serbanandi/robonaut2026/telemetry/README.md

Review Assignment Due Date (https://classroom.github.com/a/3GR8gYHV)
# Házi feladat

Név/Nevek NEPTUN kóddal:
- Minta Név (ABC123)

# Feladat kiírás
A minta feladat egy klasszikus *Aknakereső (Minesweeper)* játék elkészítése grafikus felülettel. A játék célja a mezőn lévő összes akna megtalálása, illetve az összes aknát nem rejtő mező felfedése. A játék indulásakor a pálya egyszínű négyzetekből áll, amelyek alatt aknák rejtőzködhetnek. A tábla mérete és az aknák száma nehézségi szintek alapján változik. A mezők állapota lehet lefedett, felfedett (szomszédos aknák számát mutatja), felfedett aknával, zászlós, kérdőjeles. Az egyes állapotok között az egér gombjaival válthatunk. stb, stb.
A program az alábbi funkciókkal fog rendelkezni:
* Grafikus felület Qt-ban megvalósítva.
* Nehézségi szintek választása különböző tábla méretekkel és akna számokkal.
* Az aknák véletlenszerű elhelyezése.
* A játék menetének implementálása a felsorolt mezőállapotokkal, a köztük való váltással és a vége állapotok ellenőrzésével.
* A játék idejének mérése.

# Megvalósított program
Milyen funkciókat sikerült megvalósítani? Milyen eltérések vannak a kiíráshoz képest? Hogyan kell bekonfigurálni, elindítani?

**Bemutató videó URL:**
(Szerepeljen benne minden lényeges funkció és az esetleges eltérések a kiíráshoz képest. max. 5 perc)

# Tapasztalatok
Milyen tapasztalatokat gyűjtött a feladat elkészítése során? Mi volt egyszerűbb / nehezebb a tervezetnél? Visszatekintve mit csinálna másként? (pár mondatban)
