serbanandi/robonaut2026/hardware/shield/shield.kicad_pcb

## KiCad design hardware/shield/shield.kicad_pcb (2025-11-16)

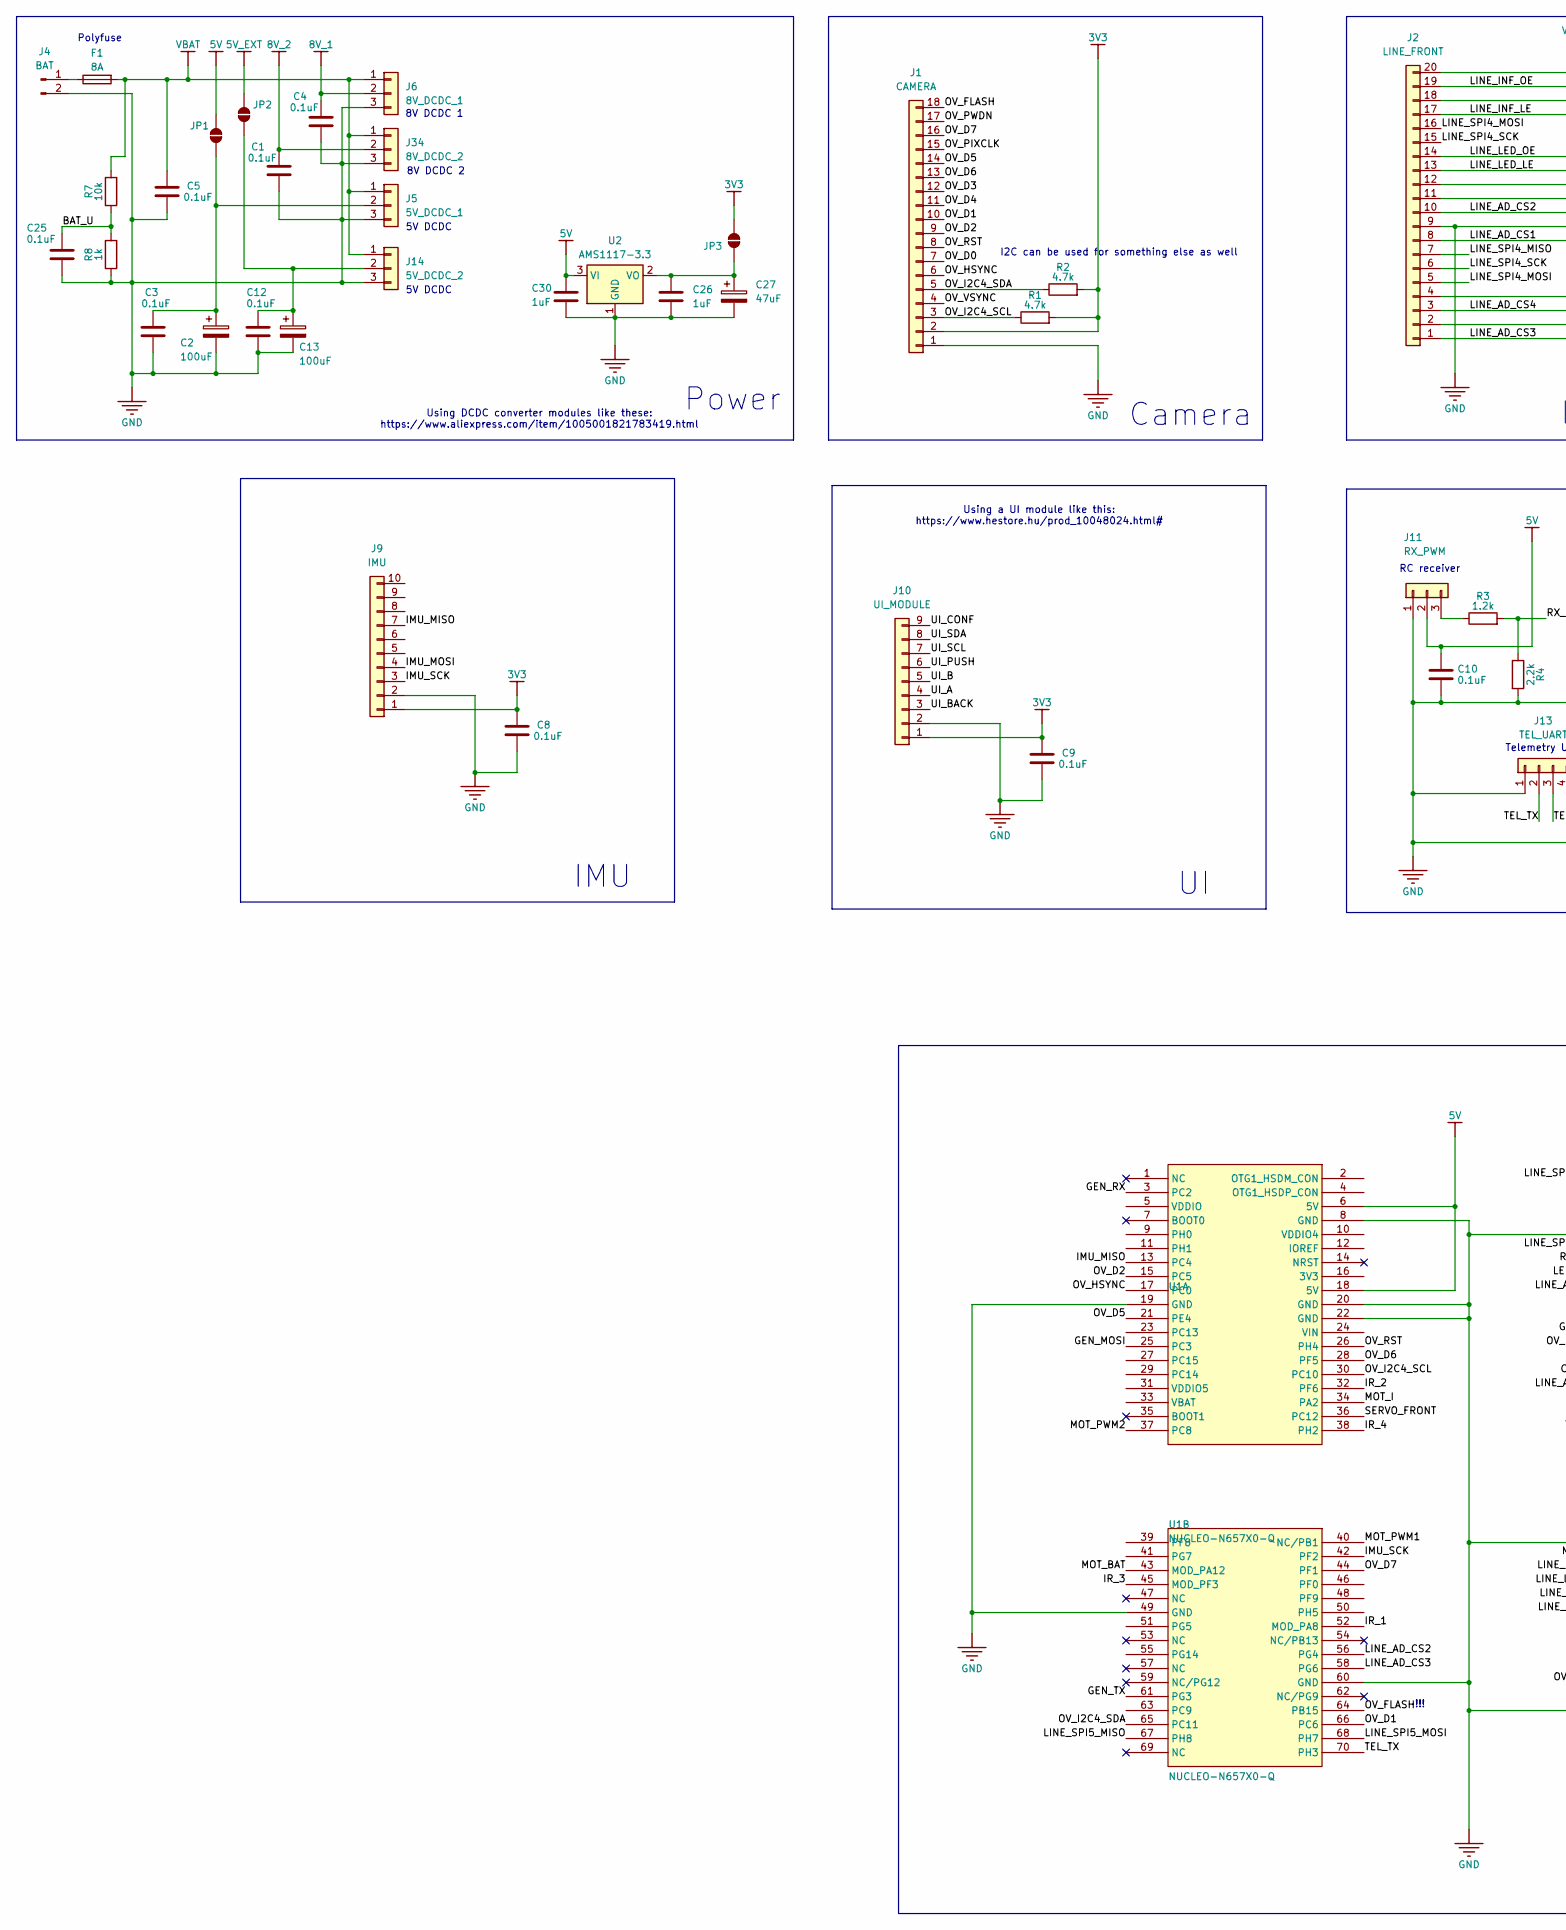
[picture p1: schematic shield.kicad_sch, part in row 1, column 1]

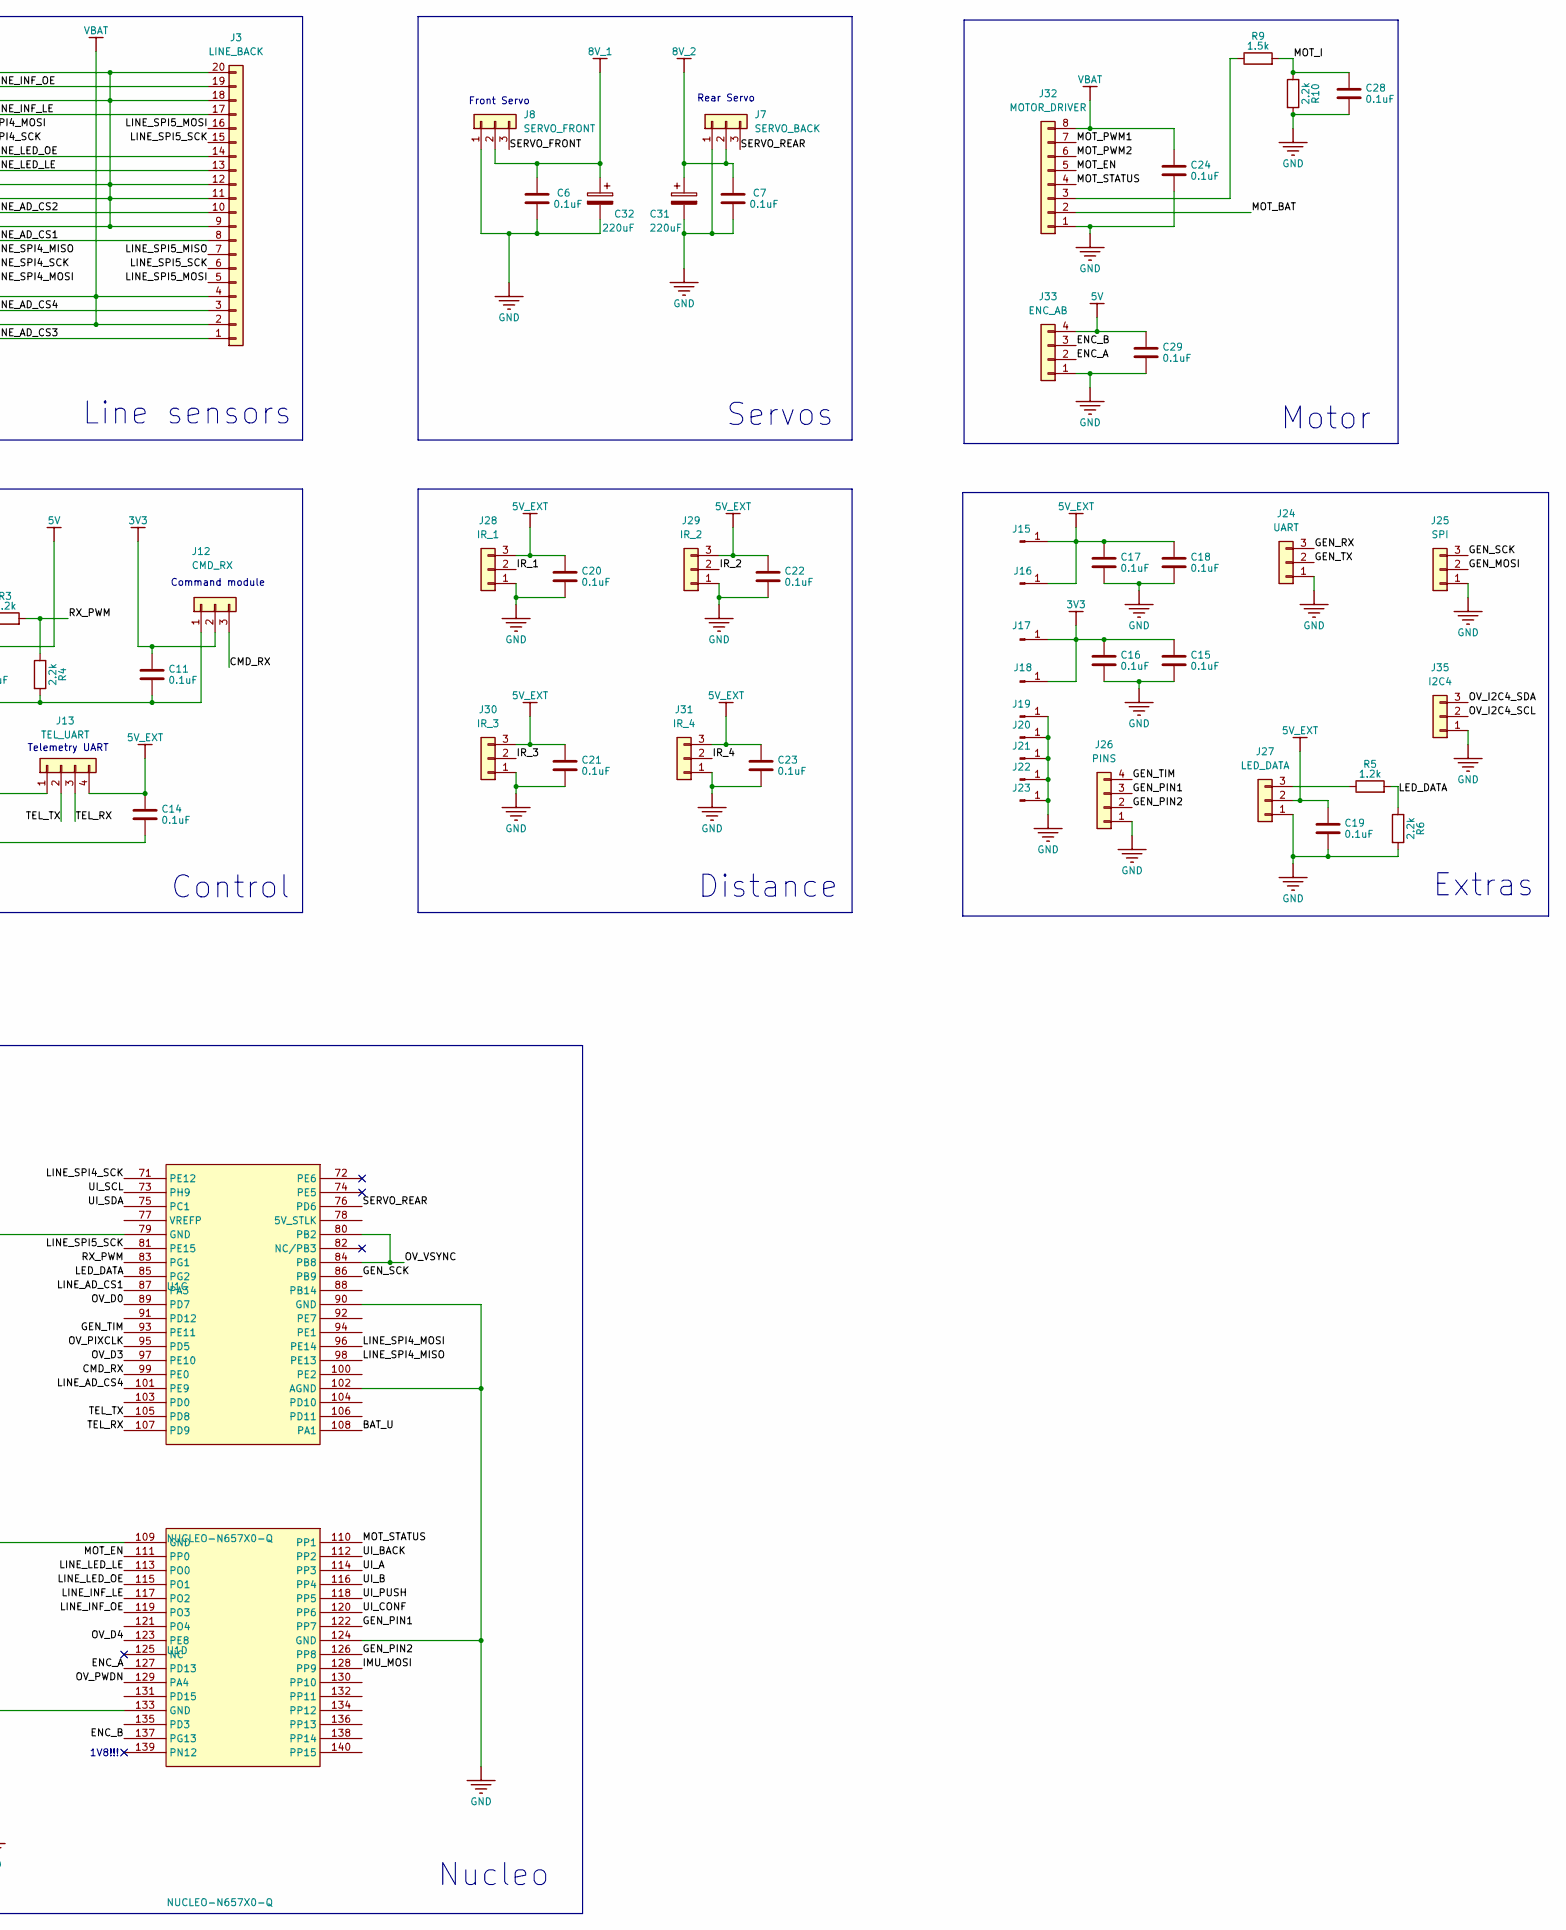
[picture p2: schematic shield.kicad_sch, part in row 1, column 2]

Parts:
C1, C3, C4, C5, C6, C7, C8, C9, C10, C11, C12, C14, C15, C16, C17, C18, C19, C20, C21, C22, C23, C24, C25, C28, C29: 0.1uF; C_0603_1608Metric
C2, C13: 100uF; CP_Elec_5x5.8
C26, C30: 1uF; C_0805_2012Metric
C27: 47uF; CP_Elec_5x5.3
C31, C32: 220uF; CP_Elec_6.3x7.7
F1: 8A; Fuseholder_Blade_Mini_Keystone_3568
J1: CAMERA; PinHeader_2x09_P2.54mm_Horizontal
J2: LINE_FRONT; PinHeader_2x10_P2.54mm_Horizontal
J3: LINE_BACK; PinHeader_2x10_P2.54mm_Horizontal
J4: BAT; TerminalBlock_MaiXu_MX126-5.0-02P_1x02_P5.00mm
J5: 5V_DCDC_1; PinHeader_1x03_P2.54mm_Vertical
J6: 8V_DCDC_1; PinHeader_1x03_P2.54mm_Vertical
J7: SERVO_BACK; PinHeader_1x03_P2.54mm_Horizontal
J8: SERVO_FRONT; PinHeader_1x03_P2.54mm_Horizontal
J9: IMU; PinHeader_1x10_P2.54mm_Vertical
J10: UI_MODULE; JST_SH_SM09B-SRSS-TB_1x09-1MP_P1.00mm_Horizontal
J11: RX_PWM; JST_SH_SM03B-SRSS-TB_1x03-1MP_P1.00mm_Horizontal
J12: CMD_RX; JST_SH_SM03B-SRSS-TB_1x03-1MP_P1.00mm_Horizontal
J13: TEL_UART; JST_SH_SM04B-SRSS-TB_1x04-1MP_P1.00mm_Horizontal
J14: 5V_DCDC_2; PinHeader_1x03_P2.54mm_Vertical
J15: 5V_TP1; Pin_D0.7mm_L6.5mm_W1.8mm_FlatFork
J16: 5V_TP2; Pin_D0.7mm_L6.5mm_W1.8mm_FlatFork
J17: 3V3_TP3; Pin_D0.7mm_L6.5mm_W1.8mm_FlatFork
J18: 3V3_TP4; Pin_D0.7mm_L6.5mm_W1.8mm_FlatFork
J19: GND_TP1; Pin_D0.7mm_L6.5mm_W1.8mm_FlatFork
J20: GND_TP2; Pin_D0.7mm_L6.5mm_W1.8mm_FlatFork
J21: GND_TP3; Pin_D0.7mm_L6.5mm_W1.8mm_FlatFork
J22: GND_TP4; Pin_D0.7mm_L6.5mm_W1.8mm_FlatFork
J23: GND; Pin_D0.7mm_L6.5mm_W1.8mm_FlatFork
J24: UART; PinHeader_1x03_P1.00mm_Vertical
J25: SPI; PinHeader_1x03_P1.00mm_Vertical
J26: PINS; PinHeader_1x04_P1.00mm_Vertical
J27: LED_DATA; JST_SH_SM03B-SRSS-TB_1x03-1MP_P1.00mm_Horizontal
J28: IR_1; JST_SH_SM03B-SRSS-TB_1x03-1MP_P1.00mm_Horizontal
J29: IR_2; JST_SH_SM03B-SRSS-TB_1x03-1MP_P1.00mm_Horizontal
J30: IR_3; JST_SH_SM03B-SRSS-TB_1x03-1MP_P1.00mm_Horizontal
J31: IR_4; JST_SH_SM03B-SRSS-TB_1x03-1MP_P1.00mm_Horizontal
J32: MOTOR_DRIVER; JST_SH_SM08B-SRSS-TB_1x08-1MP_P1.00mm_Horizontal
J33: ENC_AB; JST_SH_SM04B-SRSS-TB_1x04-1MP_P1.00mm_Horizontal
J34: 8V_DCDC_2; PinHeader_1x03_P2.54mm_Vertical
J35: I2C4; PinHeader_1x03_P1.00mm_Vertical
JP1: 5V_1; SolderJumper-2_P1.3mm_Open_TrianglePad1.0x1.5mm
JP2: 5V_2; SolderJumper-2_P1.3mm_Open_TrianglePad1.0x1.5mm
JP3: 3V3; SolderJumper-2_P1.3mm_Open_TrianglePad1.0x1.5mm
R1, R2: 4.7k; R_0603_1608Metric
R3, R5: 1.2k; R_0603_1608Metric
R4, R6, R10: 2.2k; R_0603_1608Metric
R7: 10k; R_0603_1608Metric
R8: 1k; R_0603_1608Metric
R9: 1.5k; R_0603_1608Metric
U1: NUCLEO-N657X0-Q; FP_NUCLEO-144 - N6
U2: AMS1117-3.3; SOT-223-3_TabPin2

Connections:
3V3: C8.1, C9.1, C11.1, C15.1, C16.1, J1.2, J9.1, J10.1, J12.2, J17.1, J18.1, JP3.1 (A), R1.2, R2.2
5V: C10.1, C29.1, C30.1, J11.2, J33.4, JP1.2 (B), U1.6 (5V), U1.18 (5V), U2.3 (VI)
5V_EXT: C14.1, C17.1, C18.1, C19.1, C20.1, C21.1, C22.1, C23.1, J13.4, J15.1, J16.1, J27.2, J28.3, J29.3, J30.3, J31.3, JP2.2 (B)
8V_1: C4.1, C6.1, C32.1, J6.2, J8.2
8V_2: C1.1, C7.1, C31.1, J7.2, J34.2
/BAT_U: C25.1, R7.1, R8.2, U1.108 (PA1)
/CMD_RX: J12.3, U1.99 (PE0)
/ENC_A: J33.2, U1.127 (PD13)
/ENC_B: J33.3, U1.137 (PG13)
/GEN_MOSI: J25.2, U1.25 (PC3)
/GEN_PIN1: J26.3, U1.122 (PP7)
/GEN_PIN2: J26.2, U1.126 (PP8)
/GEN_RX: J24.3, U1.3 (PC2)
/GEN_SCK: J25.3, U1.86 (PB9)
/GEN_TIM: J26.4, U1.93 (PE11)
/GEN_TX: J24.2, U1.61 (PG3)
/IMU_MISO: J9.7, U1.13 (PC4)
/IMU_MOSI: J9.4, U1.128 (PP9)
/IMU_SCK: J9.3, U1.42 (PF2)
/IR_1: J28.2, U1.52 (MOD_PA8)
/IR_2: J29.2, U1.32 (PF6)
/IR_3: J30.2, U1.45 (MOD_PF3)
/IR_4: J31.2, U1.38 (PH2)
/LED_DATA: R5.2, R6.1, U1.85 (PG2)
/LINE_AD_CS1: J2.8, J3.8, U1.87 (PA3)
/LINE_AD_CS2: J2.10, J3.10, U1.56 (PG4)
/LINE_AD_CS3: J2.1, J3.1, U1.58 (PG6)
/LINE_AD_CS4: J2.3, J3.3, U1.101 (PE9)
/LINE_INF_LE: J2.17, J3.17, U1.117 (PO2)
/LINE_INF_OE: J2.19, J3.19, U1.119 (PO3)
/LINE_LED_LE: J2.13, J3.13, U1.113 (PO0)
/LINE_LED_OE: J2.14, J3.14, U1.115 (PO1)
/LINE_SPI4_MISO: J2.7, U1.98 (PE13)
/LINE_SPI4_MOSI: J2.5, J2.16, U1.96 (PE14)
/LINE_SPI4_SCK: J2.6, J2.15, U1.71 (PE12)
/LINE_SPI5_MISO: J3.7, U1.67 (PH8)
/LINE_SPI5_MOSI: J3.5, J3.16, U1.68 (PH7)
/LINE_SPI5_SCK: J3.6, J3.15, U1.81 (PE15)
/MOT_BAT: J32.2, U1.43 (MOD_PA12)
/MOT_EN: J32.5, U1.111 (PP0)
/MOT_I: C28.1, R9.2, R10.1, U1.34 (PA2)
/MOT_PWM1: J32.7, U1.40 (NC/PB1)
/MOT_PWM2: J32.6, U1.37 (PC8)
/MOT_STATUS: J32.4, U1.110 (PP1)
/OV_D0: J1.7, U1.89 (PD7)
/OV_D1: J1.10, U1.66 (PC6)
/OV_D2: J1.9, U1.15 (PC5)
/OV_D3: J1.12, U1.97 (PE10)
/OV_D4: J1.11, U1.123 (PE8)
/OV_D5: J1.14, U1.21 (PE4)
/OV_D6: J1.13, U1.28 (PF5)
/OV_D7: J1.16, U1.44 (PF1)
/OV_FLASH: J1.18, U1.64 (PB15)
/OV_HSYNC: J1.6, U1.17 (PC0)
/OV_I2C4_SCL: J1.3, J35.2, R1.1, U1.30 (PC10)
/OV_I2C4_SDA: J1.5, J35.3, R2.1, U1.65 (PC11)
/OV_PIXCLK: J1.15, U1.95 (PD5)
/OV_PWDN: J1.17, U1.129 (PA4)
/OV_RST: J1.8, U1.26 (PH4)
/OV_VSYNC: J1.4, U1.80 (PB2), U1.84 (PB8)
/RX_PWM: R3.2, R4.1, U1.83 (PG1)
/SERVO_FRONT: J8.3, U1.36 (PC12)
/SERVO_REAR: J7.3, U1.76 (PD6)
/TEL_RX: J13.3, U1.107 (PD9)
/TEL_TX: J13.2, U1.70 (PH3), U1.105 (PD8)
/UI_A: J10.4, U1.114 (PP3)
/UI_B: J10.5, U1.116 (PP4)
/UI_BACK: J10.3, U1.112 (PP2)
/UI_CONF: J10.9, U1.120 (PP6)
/UI_PUSH: J10.6, U1.118 (PP5)
/UI_SCL: J10.7, U1.73 (PH9)
/UI_SDA: J10.8, U1.75 (PC1)
GND: C1.2, C2.2, C3.2, C4.2, C5.2, C6.2, C7.2, C8.2, C9.2, C10.2, C11.2, C12.2, C13.2, C14.2, C15.2, C16.2, C17.2, C18.2, C19.2, C20.2, C21.2, C22.2, C23.2, C24.2, C25.2, C26.2, C27.2, C28.2, C29.2, C30.2, C31.2, C32.2, J1.1, J2.9, J2.11, J2.12, J2.18, J2.20, J3.9, J3.11, J3.12, J3.18, J3.20, J4.2, J5.3, J6.3, J7.1, J8.1, J9.2, J10.2, J11.1, J12.1, J13.1, J14.3, J19.1, J20.1, J21.1, J22.1, J23.1, J24.1, J25.1, J26.1, J27.1, J28.1, J29.1, J30.1, J31.1, J32.1, J33.1, J34.3, J35.1, R4.2, R6.2, R8.1, R10.2, U1.8 (GND), U1.19 (GND), U1.20 (GND), U1.22 (GND), U1.49 (GND), U1.60 (GND), U1.79 (GND), U1.90 (GND), U1.102 (AGND), U1.109 (GND), U1.124 (GND), U1.133 (GND), U2.1 (GND)
unnamed: F1.1, J4.1
unnamed: C2.1, C3.1, J5.2, JP1.1 (A)
unnamed: J11.3, R3.1
unnamed: C12.1, C13.1, J14.2, JP2.1 (A)
unnamed: J27.3, R5.1
unnamed: J32.3, R9.1
unnamed: C26.1, C27.1, JP3.2 (B), U2.2 (VO)
VBAT: C5.1, C24.1, F1.2, J2.2, J2.4, J3.2, J3.4, J5.1, J6.1, J14.1, J32.8, J34.1, R7.2

Notes on the sheet:
Power
Nucleo
Telemetry UART
Line sensors
Camera
Polyfuse
8V DCDC 1
RC receiver
5V DCDC
I2C can be used for something else as well
Motor
8V DCDC 2
!!!
Distance
Command module
IMU
1V8!!!
Front Servo
Using DCDC converter modules like these: https://www.aliexpress.com/item/1005001821783419.html
Using a UI module like this: https://www.hestore.hu/prod_10048024.html#
Rear Servo
Extras
Servos
Control

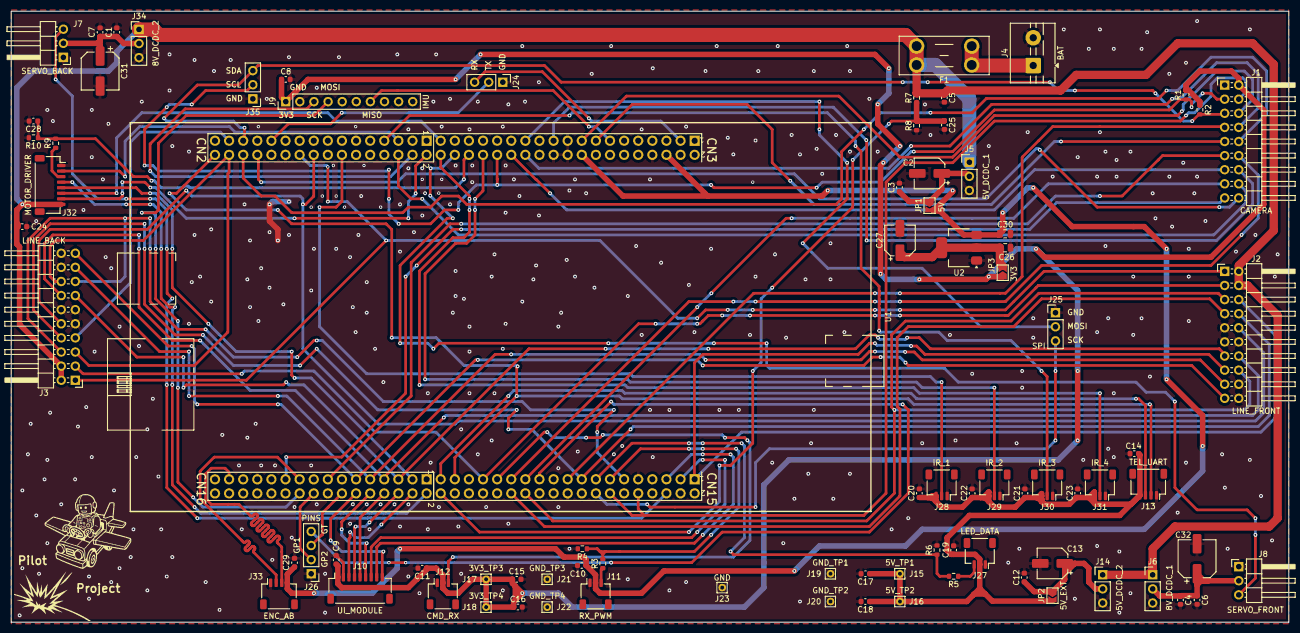
[picture p3: board shield.kicad_pcb from above]

Board: 2 copper layers, 230.0 x 110.0 mm, 83 parts (0 on the bottom side), 81 nets.
