serbanandi/robonaut2026/robonaut-firmware/robonaut-firmware.ioc

Mcu.UserName=STM32N657X0HxQ
PA1.GPIO_Label=BAT_U
PA1.Signal=ADC2_INP1
PA10.GPIO_Label=IR_2
PA10.Signal=ADC1_INP11
PA12.GPIO_Label=MOT_U
PA12.Signal=ADC2_INP13
PA13(JTMS/SWDIO).GPIO_Label=SWDIO
PA13(JTMS/SWDIO).Signal=DEBUG_JTMS-SWDIO
PA14(JTCK/SWCLK).GPIO_Label=SWCLK
PA14(JTCK/SWCLK).Signal=DEBUG_JTCK-SWCLK
PA15(JTDI).GPIO_Label=JTDI
PA15(JTDI).Signal=DEBUG_JTDI
PA2.GPIO_Label=MOT_I
PA2.Signal=ADC2_INP14
PA3.GPIO_Label=_AD_CS1 
PA3.Signal=GPIO_Output
PA7.GPIO_Label=UCPD_PWR_EN
PA7.Signal=GPIO_Output
PA8.GPIO_Label=IR_1
PA8.Signal=ADC1_INP5
PB0.GPIO_Label=TRACED1
PB0.Signal=DEBUG_TRACED1
PB1.GPIO_Label=GEN_TIM
PB1.Signal=S_TIM3_CH4
PB15.GPIO_Label=OV_FLASH
PB15.Signal=GPIO_Output
PB2.GPIO_Label=OV_VSYNC
PB2.Signal=GPIO_Input
PB3.GPIO_Label=TRACECLK
PB3.Signal=DEBUG_TRACECLK
PB5(JTDO/TRACESWO).GPIO_Label=SWO
PB5(JTDO/TRACESWO).Signal=DEBUG_JTDO-SWO
PB6.GPIO_Label=TRACED2
PB6.Signal=DEBUG_TRACED2
PB7.GPIO_Label=TRACED3
PB7.Signal=DEBUG_TRACED3
PB8.Signal=DCMIPP_VSYNC
PB9.GPIO_Label=GEN_SCK
PB9.Signal=SPI1_SCK
PC0.Signal=DCMIPP_HSYNC
PC1.GPIO_Label=UI_SDA
PC1.Signal=I2C1_SDA
PC10.Signal=I2C4_SCL
PC11.Signal=I2C4_SDA
PC12.GPIO_Label=SERVO_FRONT
PC12.Signal=S_TIM15_CH1
PC13.Signal=GPIO_Input
PC2.GPIO_Label=GEN_RX
PC2.Signal=USART2_RX
PC3.GPIO_Label=GEN_MOSI
PC3.Signal=SPI1_MOSI
PC4.GPIO_Label=IMU_MISO
PC4.Signal=SPI2_MISO
PC5.Signal=DCMIPP_D2
PC6.Signal=DCMIPP_D1
PC8.GPIO_Label=_AD_CS4
PC8.Signal=GPIO_Output
PD10.GPIO_Label=PWR_EN
PD10.Signal=GPIO_Output
PD13.GPIO_Label=ENC_A
PD13.Signal=S_TIM4_CH2
PD2.GPIO_Label=UCPD1_INT
PD2.Signal=GPIO_Input
PD5.Signal=DCMIPP_PIXCLK
PD6.GPIO_Label=SERVO_REAR
PD6.Signal=S_TIM15_CH2
PD7.Signal=DCMIPP_D0
PD8.GPIO_Label=TEL_TX
PD8.Signal=USART3_TX
PD9.GPIO_Label=TEL_RX
PD9.Signal=USART3_RX
PE0.GPIO_Label=CMD_RX
PE0.Signal=UART8_RX
PE1.Signal=UART8_TX
PE10.Signal=DCMIPP_D3
PE11.GPIO_Label=MOT_PWM1
PE11.Signal=S_TIM1_CH2
PE12.Signal=SPI4_SCK
PE13.Signal=SPI4_MISO
PE14.Signal=SPI4_MOSI
PE15.Signal=SPI5_SCK
PE3.GPIO_Label=TRACED0
PE3.Signal=DEBUG_TRACED0
PE4.Signal=DCMIPP_D5
PE5.Signal=I2C1_SCL
PE8.Signal=DCMIPP_D4
PE9.GPIO_Label=MOT_PWM2
PE9.Signal=S_TIM1_CH1
PF1.Signal=DCMIPP_D7
PF2.GPIO_Label=IMU_SCK
PF2.Signal=SPI2_SCK
PF3.GPIO_Label=IR_3
PF3.Signal=ADC1_INP16
PF5.Signal=DCMIPP_D6
PG0.Signal=GPIO_Output
PG1.GPIO_Label=RX_PWM
PG1.Signal=S_TIM13_CH1
PG10.Signal=GPIO_Output
PG13.GPIO_Label=ENC_B
PG13.Signal=S_TIM4_CH1
PG15.GPIO_Label=IR_4
PG15.Signal=ADC1_INP7
PG2.Signal=TIM17_CH1N
PG3.GPIO_Label=GEN_TX
PG3.Signal=USART2_TX
PG4.GPIO_Label=_AD_CS2 
PG4.Signal=GPIO_Output
PG6.GPIO_Label=_AD_CS3 
PG6.Signal=GPIO_Output
PG7.GPIO_Label=IMU_CS
PG7.Signal=GPIO_Output
PG8.Signal=GPIO_Output
PH2.GPIO_Label=OV_FLASH
PH2.Signal=GPIO_Output
PH4.GPIO_Label=OV_RST
PH4.Signal=GPIO_Output
PH7.Signal=SPI5_MOSI
PH8.Signal=SPI5_MISO
PH9.GPIO_Label=UI_SCL
PH9.Signal=I2C1_SCL
