serbanandi/robonaut2026/robonaut-firmware/Appli/Core/Src/main.c

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
/* Includes ------------------------------------------------------------------*/
#include "main.h"
#include "cacheaxi.h"
#include "dcmipp.h"
#include "gpdma.h"
#include "i2c.h"
#include "ramcfg.h"
#include "spi.h"
#include "tim.h"
#include "usart.h"
#include "gpio.h"

/* USER CODE BEGIN Includes */

#include "System/sys_interface.h"
#include "SimpleLogger/SimpleLogger.h"

/* USER CODE END Includes */

/* USER CODE BEGIN PD */
#define LED_PERIOD_MS	(500)
/* USER CODE END PD */


COM_InitTypeDef BspCOMInit;

static void SystemIsolation_Config(void);
/* USER CODE BEGIN 0 */
void MPU_Config(void);
/* USER CODE END 0 */

/**
  * @brief  The application entry point.
  * @retval int
  */
int main(void)
{

  /* USER CODE BEGIN 1 */
  MPU_Config();
  /* USER CODE END 1 */

  /* Enable the CPU Cache */

  /* Enable I-Cache---------------------------------------------------------*/
  SCB_EnableICache();

  /* Enable D-Cache---------------------------------------------------------*/
  SCB_EnableDCache();

  /* MCU Configuration--------------------------------------------------------*/
  HAL_Init();

  /* Initialize all configured peripherals */
  MX_GPIO_Init();
  MX_GPDMA1_Init();
  MX_DCMIPP_Init();
  MX_RAMCFG_Init();
  MX_I2C4_Init();
  MX_SPI4_Init();
  MX_SPI5_Init();
  MX_TIM6_Init();
  MX_CACHEAXI_Init();
  MX_SPI2_Init();
  MX_TIM3_Init();
  MX_TIM13_Init();
  MX_TIM15_Init();
  MX_USART2_UART_Init();
  MX_USART3_UART_Init();
  MX_TIM4_Init();
  MX_I2C1_Init();
  MX_SPI1_Init();
  MX_TIM1_Init();
  MX_UART8_Init();
  MX_TIM17_Init();
  MX_TIM14_Init();
  MX_TIM7_Init();
  SystemIsolation_Config();
  /* Initialize leds */
  BSP_LED_Init(LED_BLUE);
  BSP_LED_Init(LED_RED);
  BSP_LED_Init(LED_GREEN);

  /* Initialize USER push-button, will be used to trigger an interrupt each time it's pressed.*/
  BSP_PB_Init(BUTTON_USER, BUTTON_MODE_EXTI);

  /* Initialize COM1 port (115200, 8 bits (7-bit data + 1 stop bit), no parity */
  BspCOMInit.BaudRate   = 115200;
  BspCOMInit.WordLength = COM_WORDLENGTH_8B;
  BspCOMInit.StopBits   = COM_STOPBITS_1;
  BspCOMInit.Parity     = COM_PARITY_NONE;
  BspCOMInit.HwFlowCtl  = COM_HWCONTROL_NONE;
  if (BSP_COM_Init(COM1, &BspCOMInit) != BSP_ERROR_NONE)
  {
    Error_Handler();
  }

  /* Infinite loop */
  /* USER CODE BEGIN WHILE */
  
  BspCOMInit.BaudRate = 921600;
  if (BSP_COM_Init(COM1, &BspCOMInit) != BSP_ERROR_NONE)
	  Error_Handler();

  sys_Init();
  sys_Run();

  while (1)
  {
    /* USER CODE END WHILE */

    /* USER CODE BEGIN 3 */
  }
  /* USER CODE END 3 */
}

/**
  * @brief Peripherals Common Clock Configuration
  * @retval None
  */
void PeriphCommonClock_Config(void)
{
  RCC_PeriphCLKInitTypeDef PeriphClkInitStruct = {0};

  /** Initializes the peripherals clock
  */
  PeriphClkInitStruct.PeriphClockSelection = RCC_PERIPHCLK_TIM;
  PeriphClkInitStruct.TIMPresSelection = RCC_TIMPRES_DIV4;
  if (HAL_RCCEx_PeriphCLKConfig(&PeriphClkInitStruct) != HAL_OK)
  {
    Error_Handler();
  }
}

/**
  * @brief RIF Initialization Function
  * @param None
  * @retval None
  */
  static void SystemIsolation_Config(void)
{

  /* set all required IPs as secure privileged */
  __HAL_RCC_RIFSC_CLK_ENABLE();

  /* RIF-Aware IPs Config */

  /* set up GPDMA configuration */
  /* set GPDMA1 channel 0 used by USART3 */
  if (HAL_DMA_ConfigChannelAttributes(&handle_GPDMA1_Channel0,DMA_CHANNEL_SEC|DMA_CHANNEL_PRIV|DMA_CHANNEL_SRC_SEC|DMA_CHANNEL_DEST_SEC)!= HAL_OK )
  {
    Error_Handler();
  }
  /* set GPDMA1 channel 1 used by USART3 */
  if (HAL_DMA_ConfigChannelAttributes(&handle_GPDMA1_Channel1,DMA_CHANNEL_SEC|DMA_CHANNEL_PRIV|DMA_CHANNEL_SRC_SEC|DMA_CHANNEL_DEST_SEC)!= HAL_OK )
  {
    Error_Handler();
  }

}

/* USER CODE BEGIN 4 */

/* USER CODE BEGIN 4 */
void MPU_Config(void)
{
  MPU_Region_InitTypeDef default_config = {0};
  MPU_Attributes_InitTypeDef attr_config = {0};
  uint32_t primask_bit = __get_PRIMASK();
  __disable_irq();

  /* disable the MPU */
  HAL_MPU_Disable();

  /* create an attribute configuration for the MPU */
  attr_config.Attributes = INNER_OUTER(MPU_NOT_CACHEABLE);
  attr_config.Number = MPU_ATTRIBUTES_NUMBER0;

  HAL_MPU_ConfigMemoryAttributes(&attr_config);

  /* Create a non cacheable region */
  /*Normal memory type, code execution allowed */
  default_config.Enable = MPU_REGION_ENABLE;
  default_config.Number = MPU_REGION_NUMBER0;
  default_config.BaseAddress = __NON_CACHEABLE_SECTION_BEGIN;
  default_config.LimitAddress = __NON_CACHEABLE_SECTION_END;
  default_config.DisableExec = MPU_INSTRUCTION_ACCESS_ENABLE;
  default_config.AccessPermission = MPU_REGION_ALL_RW;
  default_config.IsShareable = MPU_ACCESS_NOT_SHAREABLE;
  default_config.AttributesIndex = MPU_ATTRIBUTES_NUMBER0;
  HAL_MPU_ConfigRegion(&default_config);

  /* enable the MPU */
  HAL_MPU_Enable(MPU_PRIVILEGED_DEFAULT);

  /* Exit critical section to lock the system and avoid any issue around MPU mechanisme */
  __set_PRIMASK(primask_bit);
}

/* USER CODE END 4 */
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
