serbanandi/robonaut2026/robonaut-firmware/Appli/HwDrivers/Drive/impl/drv.h

#ifndef DRV_H
#define DRV_H

#include "tim.h"

#define DRV_ENCODER_SPEED_TIMER &htim7 // Timer for speed calculation, 1 tick = 1us

void _drv_TimerInterruptHandler(void*);

void _drv_HandleSpeedControl();

#endif // DRV_H
