serbanandi/robonaut2026/robonaut-firmware/FSBL/Core/Src/bsec.c

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
/* Includes ------------------------------------------------------------------*/
#include "bsec.h"

/* BSEC init function */
void MX_BSEC_Init(void)
{

  /* USER CODE BEGIN BSEC_Init 0 */
  // Enable debug for everyone
  BSEC_HandleTypeDef hbsec;
  hbsec.Instance = BSEC;

  BSEC_DebugCfgTypeDef debugCfg;
  debugCfg.HDPL_Open_Dbg = HAL_BSEC_OPEN_DBG_LEVEL_0;
  debugCfg.Sec_Dbg_Auth = HAL_BSEC_SEC_DBG_AUTH;
  debugCfg.NonSec_Dbg_Auth = HAL_BSEC_NONSEC_DBG_AUTH;

  __HAL_RCC_BSEC_CLK_ENABLE();

  if (HAL_BSEC_ConfigDebug(&hbsec, &debugCfg) != HAL_OK)
  {
	  Error_Handler();
  }
  if (HAL_BSEC_UnlockDebug(&hbsec) != HAL_OK)
  {
	  Error_Handler();
  }
  /* USER CODE END BSEC_Init 0 */

}
