serbanandi/robonaut2026/robonaut-firmware/Appli/Utils/IntHandler/impl/int_listManager.c

#include "../int_interface.h"
#include "int_list.h"
#include "stm32n6xx_hal.h"

_int_CallbackListEntry _int_callbackList[INT_EVENT_TYPE_COUNT][_INT_MAX_SUBSCR_COUNT + 1] = { 0 };

uint8_t int_SubscribeToInt(int_IntEventType eventType, int_CallbackFn cbFnHandle, void* context, void* halHandle)
{
    if (eventType >= INT_EVENT_TYPE_COUNT)
        return 0;

    for (uint32_t p = 0; p < _INT_MAX_SUBSCR_COUNT; p++)
    {
        if (_int_callbackList[eventType][p].cbFn == 0)
        {
            __disable_irq();
            _int_callbackList[eventType][p].cbFn = cbFnHandle;
            _int_callbackList[eventType][p].context = context;
            _int_callbackList[eventType][p].halHandle = halHandle;
            __enable_irq();
            return 1;
        }
    }
    return 0;
}

void _int_triggerCbs(int_IntEventType eventType, void* handle)
{
    _int_CallbackListEntry* eventCbList = _int_callbackList[eventType];

    for (uint32_t i = 0; eventCbList[i].cbFn != 0; i++)
    {
        if (eventCbList[i].halHandle == handle)
            eventCbList[i].cbFn(eventCbList[i].context);
    }
}
