serbanandi/robonaut2026/(commit log)

2025-09-27 schematic design started
    [shield.kicad_pcb, shield.kicad_sch]
2025-10-04 first schematic version and .ioc pin config
    [shield.kicad_sch]
2025-10-12 minor sch fixes and footprint assignment
    [shield.kicad_pcb, shield.kicad_sch]
2025-10-12 larger pin headers
    [shield.kicad_pcb, shield.kicad_sch]
2025-10-16 Approx layout done
    [shield.kicad_pcb, shield.kicad_sch]
2025-10-18 PCB v1 done
    [shield.kicad_pcb]
2025-10-20 Fixed DRCs, added labels to silkscreen
    [shield.kicad_pcb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]
2025-11-17 servo impl and motor pwm pin changes
    [shield.kicad_sch]
2025-11-18 Added define for 1 line sensor
2025-11-18 motor driver impl
    [shield.kicad_sch]
2025-12-12 implement initial telemetry and uart version
2025-12-12 fix telemetry issues and refactor code
    [int_intHandler.c, int_list.h, int_listManager.c, sys_main.c, tel.c, tel.h]
2025-12-12 convert uart operations to use dma
2025-12-14 add imu cs pin config and fix ui module init freeze
    [main.c, main.h, robonaut-firmware.ioc]
2025-12-14 add tim18 for imu readouts
2025-12-14 IMU driver and init
2025-12-15 q2 solution v1 - junctions unstable
    [line.c, sys_main.c]
2025-12-15 q2 solution v1.1 - junctions still unstable
    [line.c, sys_main.c]
2026-01-29 RC fix mert buzis normálisan ledokumentálni az időzítést
    [rc.c]
