serbanandi/robonaut2026/(notices)

Notices in the files:
robonaut-firmware/Appli/Core/Inc/main.h:
Copyright (c) 2025 STMicroelectronics.
All rights reserved.
This software is licensed under terms that can be found in the LICENSE file
